petrsykora/pylontech_Lan_Interface/PCB_design/BOM_pylontec_mqttinterface1b.txt

Stückliste exportiert aus M:/Projekte/projects_misc/PV/LAN_universalinterface/PCB_design/pylontec_mqttinterface1b.sch am 03.12.2025 09:30

Part      Value      Device              Package          Description                                      AVAILABILITY CHECK_PRICES                                                             DESCRIPTION                                                                                                                                 MF               MP         MPN        OC_FARNELL OC_NEWARK PACKAGE POPULARITY PRICE SNAPEDA_LINK                                                              SPICEPREFIX
485TERM              JP1E                JP1              JUMPER                                                                                                                                                                                                                                                                                                                                                 61                                                                                                    
C1        100nF      C-EUC0805           C0805            CAPACITOR, European symbol                                                                                                                                                                                                                                                                                                                                                                                                                                   
C2        47n        C-EUC0805           C0805            CAPACITOR, European symbol                                                                                                                                                                                                                                                                                                                                                                                                                                   
C3        330n       C-EUC0805           C0805            CAPACITOR, European symbol                                                                                                                                                                                                                                                                                                                                                                                                                                   
C4        330n       C-EUC0805           C0805            CAPACITOR, European symbol                                                                                                                                                                                                                                                                                                                                                                                                                                   
C5        330n       C-EUC0805           C0805            CAPACITOR, European symbol                                                                                                                                                                                                                                                                                                                                                                                                                                   
C6        1uF        C-EUC1210           C1210            CAPACITOR, European symbol                                                                                                                                                                                                                                                                                                                             0                                                                                          C          
C7        1uF        C-EUC1210           C1210            CAPACITOR, European symbol                                                                                                                                                                                                                                                                                                                             0                                                                                          C          
C8        1uF        C-EUC1210           C1210            CAPACITOR, European symbol                                                                                                                                                                                                                                                                                                                             0                                                                                          C          
C9        1uF        C-EUC1210           C1210            CAPACITOR, European symbol                                                                                                                                                                                                                                                                                                                             0                                                                                          C          
C10       1uF        C-EUC1210           C1210            CAPACITOR, European symbol                                                                                                                                                                                                                                                                                                                             0                                                                                          C          
C35       100nF      C-EUC0805           C0805            CAPACITOR, European symbol                                                                                                                                                                                                                                                                                                                                                                                                                                   
CAN                  W237-102            W237-102         WAGO SCREW CLAMP                                                                                                                                                                                                                                                                                               237-102    unknown    70K9898           32                                                                                                    
CTERM                JP1E                JP1              JUMPER                                                                                                                                                                                                                                                                                                                                                 61                                                                                                    
IC1       MAX3232CSE MAX3232CSE          SO16             True RS-232 Transceivers 3.0V to 5.5V, Low-Power                                                                                                                                                                                                                                                               MAX3232CSE 9725490    90C2890           1                                                                                                     
IC2       SN65HVD230 TJA1040             SO8                                                                                                                                                                                                                                                                                                                                                                                                                                                                           
IC3       MAX485     MAX481CSA           SO08             RS485 TRANSEIVER                                                                                                                                                                                                                                                                   MAXIM                       MAX481CSA  unknown    90C3817           4                                                                                                     
LED1                 LED_LEDCHIPLED_0805 LED_CHIPLED_0805 LED                                                                                                                                                                                                                                                                                                                                                                                                                                                          
NRF24L01+            MA04-2              MA04-2           PIN HEADER                                                                                                                                                                                                                                                                                                                unknown    unknown           11                                                                                                    
PROG                 JP1E                JP1              JUMPER                                                                                                                                                                                                                                                                                                                                                 61                                                                                                    
Q1        BSS123     BSS123              SOT23            N-CHANNEL MOS FET                                                                                                                                                                                                                                                                                                                                      21                                                                                                    
Q2        BSS123     BSS123              SOT23            N-CHANNEL MOS FET                                                                                                                                                                                                                                                                                                                                      21                                                                                                    
R1        10k        R-EU_R0805          R0805            RESISTOR, European symbol                                                                                                                                                                                                                                                                                                                                                                                                                                    
R2        180R       R-EU_R0805          R0805            RESISTOR, European symbol                                                                                                                                                                                                                                                                                                                                                                                                                                    
R3        10k        R-EU_R0805          R0805            RESISTOR, European symbol                                                                                                                                                                                                                                                                                                                                                                                                                                    
R4        10k        R-EU_R0805          R0805            RESISTOR, European symbol                                                                                                                                                                                                                                                                                                                                                                                                                                    
R5        10k        R-EU_R0805          R0805            RESISTOR, European symbol                                                                                                                                                                                                                                                                                                                                                                                                                                    
R6        120R       R-EU_R0805          R0805            RESISTOR, European symbol                                                                                                                                                                                                                                                                                                                                                                                                                                    
R7        120R       R-EU_R0805          R0805            RESISTOR, European symbol                                                                                                                                                                                                                                                                                                                                                                                                                                    
R8        1k         R-EU_R0805          R0805            RESISTOR, European symbol                                                                                                                                                                                                                                                                                                                                                                                                                                    
R9        1k         R-EU_R0805          R0805            RESISTOR, European symbol                                                                                                                                                                                                                                                                                                                                                                                                                                    
R10       10k        R-EU_R0805          R0805            RESISTOR, European symbol                                                                                                                                                                                                                                                                                                                                                                                                                                    
R11       10k        R-EU_R0805          R0805            RESISTOR, European symbol                                                                                                                                                                                                                                                                                                                                                                                                                                    
R12       10k        R-EU_R0805          R0805            RESISTOR, European symbol                                                                                                                                                                                                                                                                                                                                                                                                                                    
R13       10k        R-EU_R0805          R0805            RESISTOR, European symbol                                                                                                                                                                                                                                                                                                                                                                                                                                    
RS485                MA04-1              MA04-1           PIN HEADER                                                                                                                                                                                                                                                                                                                unknown    unknown           41                                                                                                    
SJ1                  SJ                  SJ               SMD solder JUMPER                                                                                                                                                                                                                                                                                                                                      33                                                                                                    
SJ2                  SJ                  SJ               SMD solder JUMPER                                                                                                                                                                                                                                                                                                                                      33                                                                                                    
SJ3                  SJ                  SJ               SMD solder JUMPER                                                                                                                                                                                                                                                                                                                                      33                                                                                                    
SJ4                  SJ                  SJ               SMD solder JUMPER                                                                                                                                                                                                                                                                                                                                      33                                                                                                    
TO-FTDI              MA04-1              MA04-1           PIN HEADER                                                                                                                                                                                                                                                                                                                unknown    unknown           41                                                                                                    
U$2       WT32-ETH01 WT32-ETH01          WT32-ETH01       Check availability                               Not in stock https://www.snapeda.com/parts/WT32-ETH01/Wireless-Tag/view-part/?ref=eda                                                       Embedded serial port to Ethernet module                                               wireless-tag     WT32-ETH01                                 None               None  https://www.snapeda.com/parts/WT32-ETH01/Wireless-Tag/view-part/?ref=snap            
X1        RJ45-8L-B  RJ45-8L-B           RJ45-NO-SHIELD   CORCOM Modular RJ Jacks No Shield                                                                                                                                                                                                                                                  TYCO ELECTRONICS            RJ45-8L-B  1279843    52K4445           0                                                                                                     
X2                   SMARTPRJ_PN61729    SMARTPRJ_PN61729 BERG USB connector
