petrsykora/pylontech_Lan_Interface/PCB_design/pylontec_mqttinterface1b_schematic.pdf

## GND +5V

7 IC3 | GND VCC8 5 IC3P | R⁷

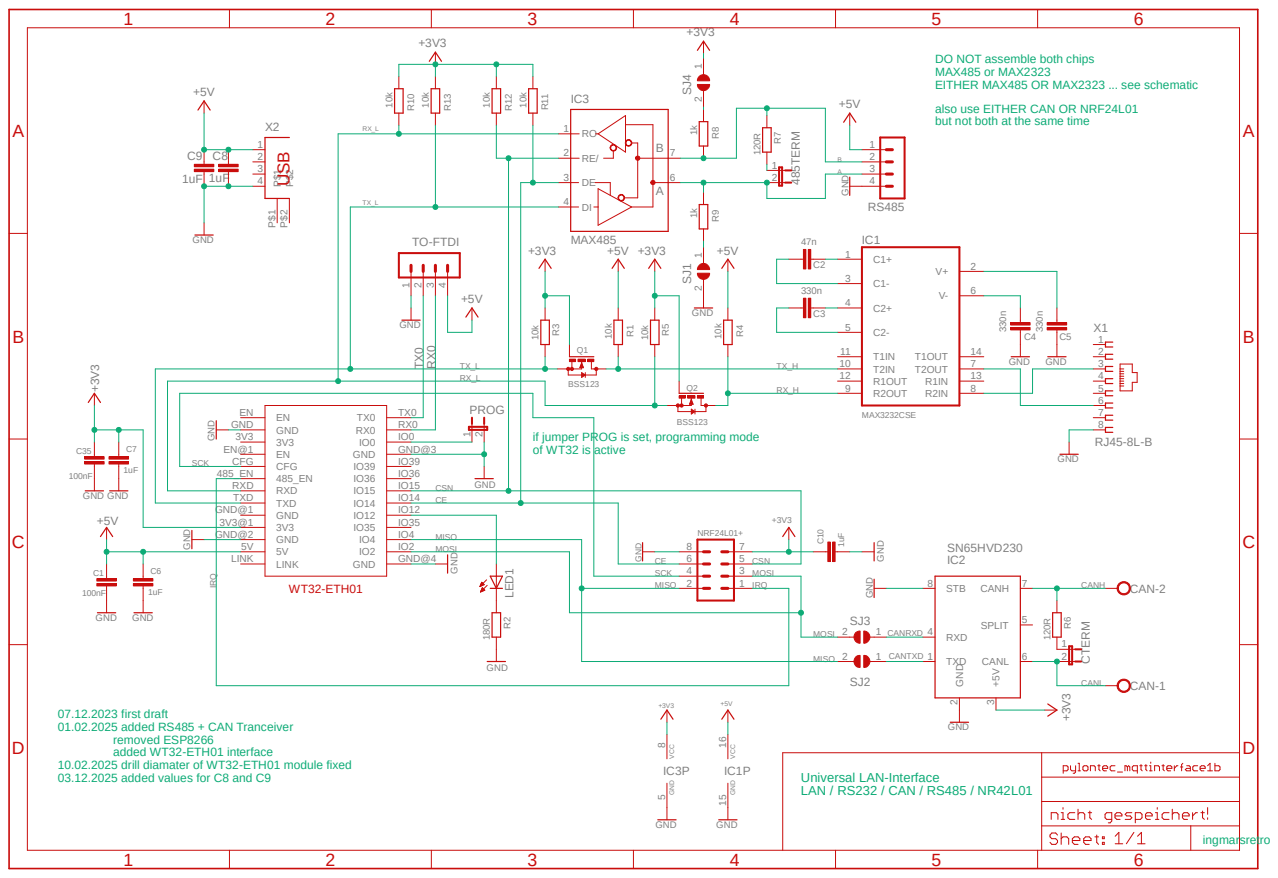
[picture p1: page 1]

DO NOT assemble both chips
MAX485 or MAX2323
EITHER MAX485 OR MAX2323 ... see schematic
also use EITHER CAN OR NRF24L01
but not both at the same time

if jumper PROG is set, programming mode
of WT32 is active
GND180R GND

10.02.2025 drill diamater of WT32-ETH01 module fixed
03.12.2025 added values for C8 and C9
