petrsykora/pylontech_Lan_Interface/(commit log)

2025-12-03 Add files via upload
    the values for capacitors C8,C9 added in schematic . (If it is neccesary to assemble them, depends on the output quality of you 5V USB Supply) in case they are spare
    productionfile for pcb vendors updated
    [pylontec_mqttinterface1b.brd, pylontec_mqttinterface1b.sch]
2026-02-17 Create Pylontech HA panel configuration
    Added a new YAML configuration for the Pylontech HA panel with various cards displaying battery metrics.
